ET3054/taktgeber/Flachbaugruppe.kicad_pcb

## KiCad design Flachbaugruppe.kicad_pcb (2026-10-05)

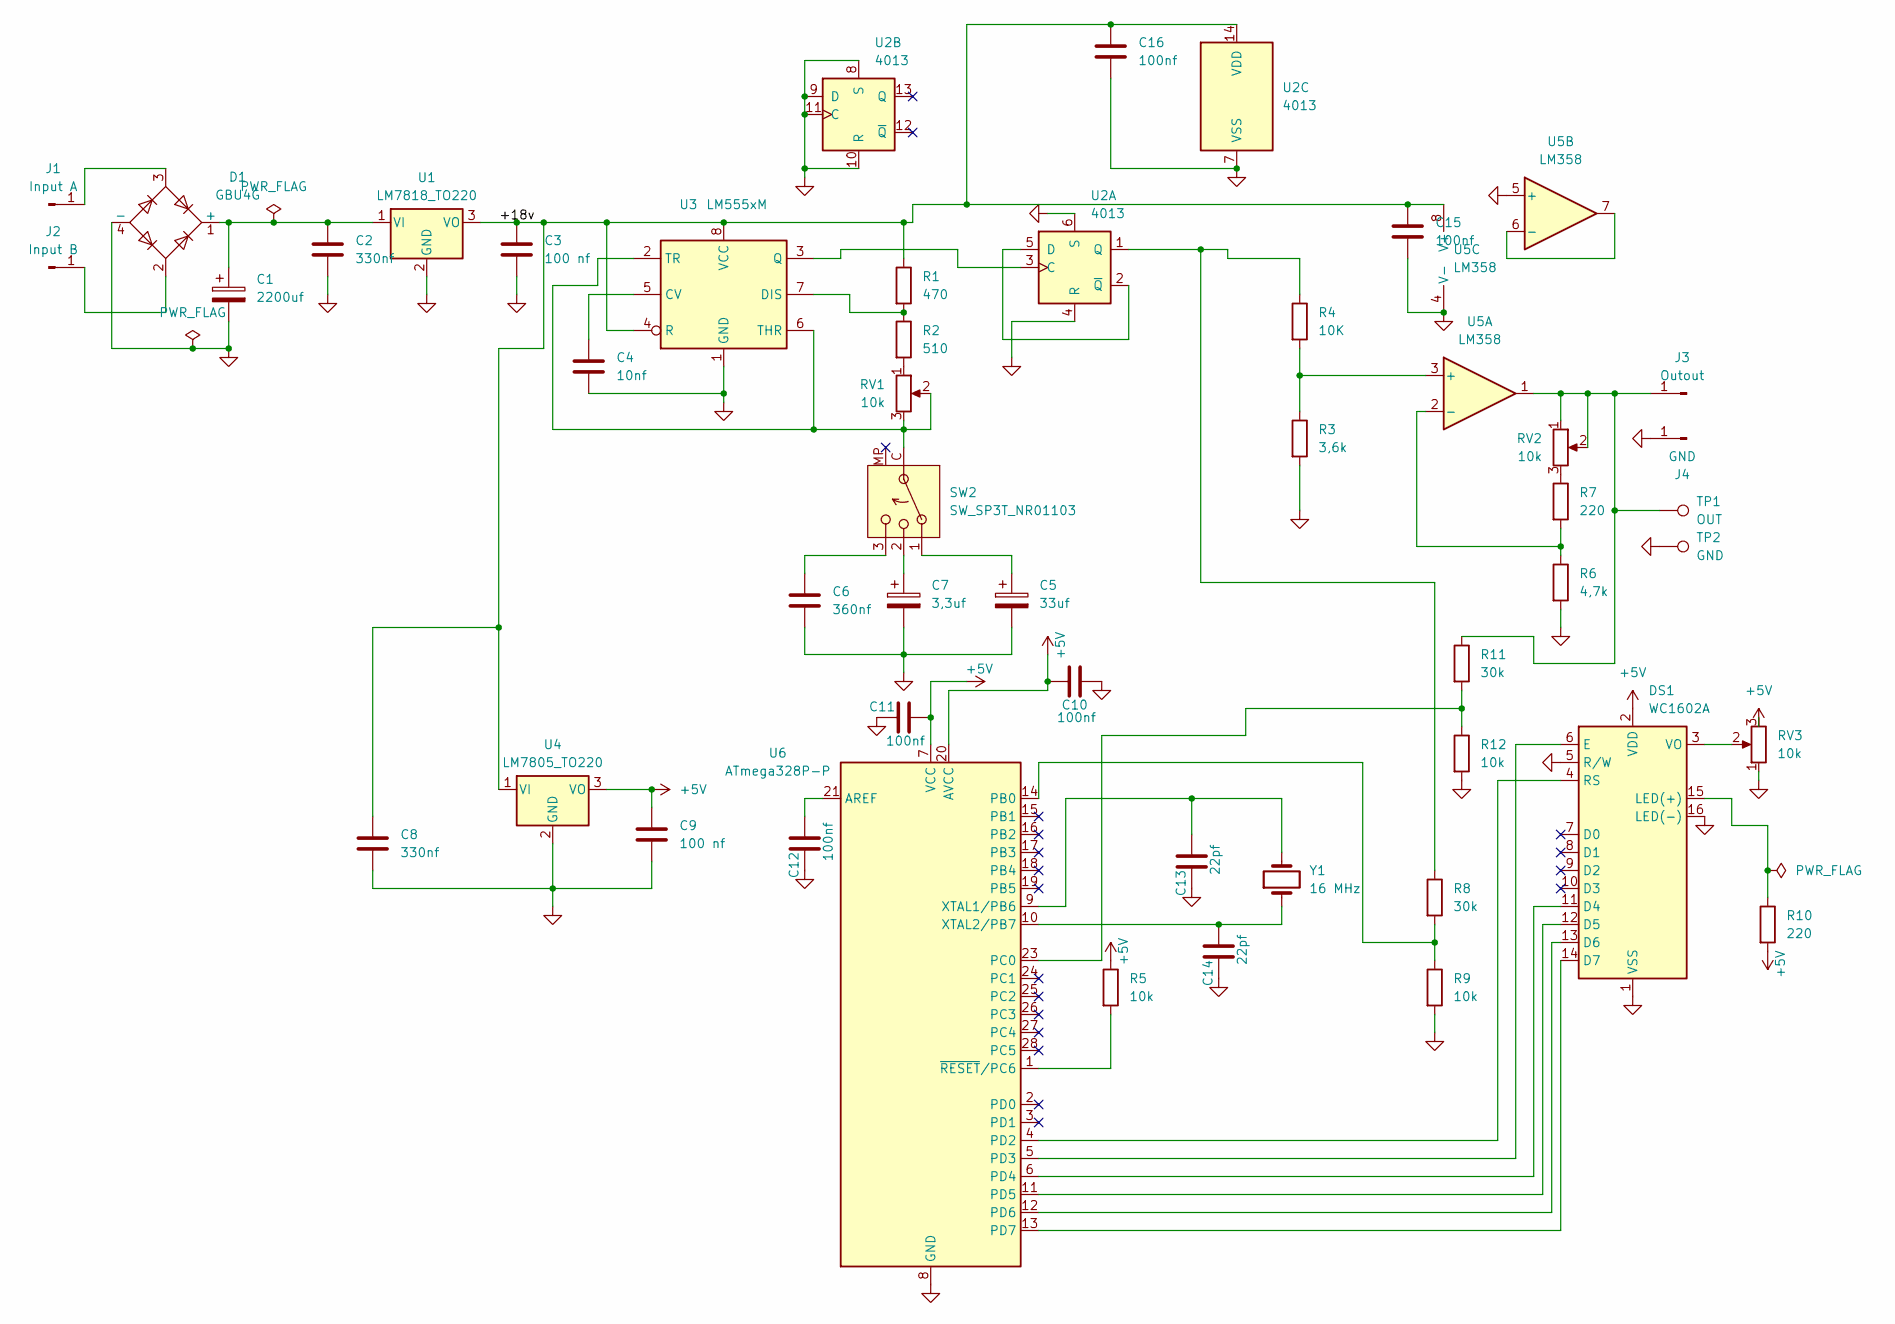
[picture p1: schematic Flachbaugruppe.kicad_sch]

Parts:
C1: 2200uf; CP_Radial_D16.0mm_P7.50mm
C2, C8: 330nf; C_0805_2012Metric
C3, C9: 100 nf; C_0805_2012Metric
C4: 10nf; C_0805_2012Metric
C5: 33uf; CP_Radial_D6.3mm_P2.50mm
C6: 360nf; C_0805_2012Metric
C7: 3,3uf; CP_Radial_D5.0mm_P2.00mm
C10, C11, C12, C15, C16: 100nf; C_0805_2012Metric
C13, C14: 22pf; C_0805_2012Metric
D1: GBU4G; Diode_Bridge_Vishay_GBU
DS1: WC1602A
J1: Input A; Banana_Jack_1Pin
J2: Input B; Banana_Jack_1Pin
J3: Outout; Banana_Jack_1Pin
J4: GND; Banana_Jack_1Pin
R1: 470; R_0805_2012Metric
R2: 510; R_0805_2012Metric
R3: 3,6k; R_0805_2012Metric
R4: 10K; R_0805_2012Metric
R5, R9, R12: 10k; R_0805_2012Metric
R6: 4,7k; R_0805_2012Metric
R7, R10: 220; R_0805_2012Metric
R8, R11: 30k; R_0805_2012Metric
RV1, RV2: 10k; Potentiometer_Alps_RK09K_Single_Horizontal
RV3: 10k; Potentiometer_Bourns_3296W_Vertical
SW2: SW_SP3T_NR01103; SW_NKK_NR01
TP1: OUT; TestPoint_Loop_D2.50mm_Drill1.0mm
TP2: GND; TestPoint_Loop_D2.50mm_Drill1.0mm
U1: LM7818_TO220; TO-220-3_Vertical
U2: 4013; DIP-14_W7.62mm
U3: LM555xM; DIP-8_W7.62mm
U4: LM7805_TO220; TO-220-3_Vertical
U5: LM358; DIP-8_W7.62mm
U6: ATmega328P-P; DIP-28_W7.62mm
Y1: 16 MHz; Crystal_HC49-U_Vertical

Connections:
+5V: C9.1, C10.1, C11.2, DS1.2 (VDD), R5.1, R10.2, RV3.3, U4.3 (VO), U6.7 (VCC), U6.20 (AVCC)
/+18v: C3.1, C8.1, C15.1, C16.1, R1.1, U1.3 (VO), U2.14 (VDD), U3.4 (R), U3.8 (VCC), U4.1 (VI), U5.8 (V+)
GND: C1.2, C2.2, C3.2, C4.2, C5.2, C6.2, C7.2, C8.2, C9.2, C10.2, C11.1, C12.1, C13.1, C14.1, C15.2, C16.2, D1.4 (-), DS1.1 (VSS), DS1.5 (R/W), DS1.16 (LED(-)), J4.1, R3.2, R6.2, R9.2, R12.2, RV3.1, TP2.1, U1.2 (GND), U2.4 (R), U2.6 (S), U2.7 (VSS), U2.8 (S), U2.9 (D), U2.10 (R), U2.11 (C), U3.1 (GND), U4.2 (GND), U5.4 (V-), U5.5 (+), U6.8 (GND), U6.22 (GND)
unnamed: C5.1, SW2.1
unnamed: C6.1, SW2.3
unnamed: C7.1, SW2.2
unnamed: C1.1, C2.1, D1.1 (+), U1.1 (VI)
unnamed: DS1.11 (D4), U6.6 (PD4)
unnamed: DS1.12 (D5), U6.11 (PD5)
unnamed: DS1.13 (D6), U6.12 (PD6)
unnamed: DS1.14 (D7), U6.13 (PD7)
unnamed: DS1.6 (E), U6.5 (PD3)
unnamed: DS1.15 (LED(+)), R10.1
unnamed: DS1.4 (RS), U6.4 (PD2)
unnamed: DS1.3 (VO), RV3.2
unnamed: D1.3, J1.1
unnamed: D1.2, J2.1
unnamed: J3.1, R11.1, RV2.1, RV2.2, TP1.1, U5.1
unnamed: R2.2, RV1.1
unnamed: R7.1, RV2.3
unnamed: RV1.2, RV1.3, SW2.C (Common), U3.2 (TR), U3.6 (THR)
unnamed: U2.3 (C), U3.3 (Q)
unnamed: U2.2 (~Q), U2.5 (D)
unnamed: R4.1, R8.1, U2.1 (Q)
unnamed: C4.1, U3.5 (CV)
unnamed: R1.2, R2.1, U3.7 (DIS)
unnamed: R3.1, R4.2, U5.3 (+)
unnamed: R6.1, R7.2, U5.2 (-)
unnamed: U5.6 (-), U5.7
unnamed: C12.2, U6.21 (AREF)
unnamed: R8.2, R9.1, U6.14 (PB0)
unnamed: R11.2, R12.1, U6.23 (PC0)
unnamed: C13.2, U6.9 (XTAL1/PB6), Y1.2
unnamed: C14.2, U6.10 (XTAL2/PB7), Y1.1
unnamed: R5.2, U6.1 (~RESET/PC6)

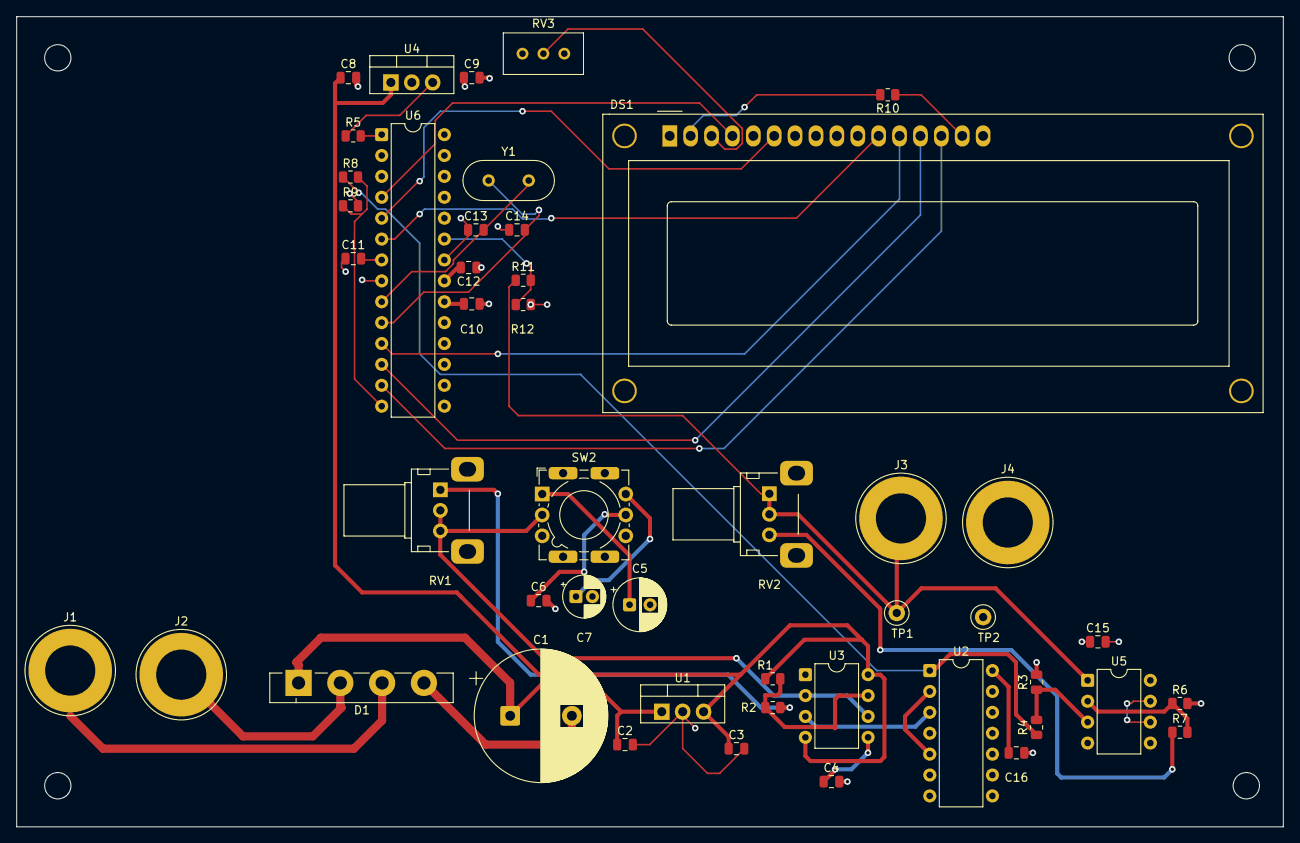
[picture p2: board Flachbaugruppe.kicad_pcb from above]

Board: 4 copper layers, 154.0 x 98.5 mm, 51 parts (0 on the bottom side), 35 nets.

Other parts of the board:
H1, H2, H3, H4: MountingHole_3.2mm_M3
